carl1961/Telsa-Coil-Winder/Documentation/TelsaCoilWinder.docx

## Overview

The Telsa coil winder was inspired by my son building a couple of different Telsa coil projects. For these projects we would wind and unwind after we noticed an overlap in the wire. It took hours to build a coil that was free of overlaps. A few times, we noticed the overlap only after the coil was completed. We took our chances only to discover that the wire would arc on the overlap destroying the coil.

Our initial solution was to build a coil winder that used a 12-volt motor and foot peddle to slowly turn the coil while you used your fingers to place the wire in the coil. This approach was better than the first, but still proved to be troublesome. We could wind the coil faster, but we also discovered overlap much later which required more unwinding to fix the issues.

We started searching the web for any tesla coil winders that someone might have built. I was not able to find exactly what I was looking for, but I was able to find enough information to develop an approach and identify the required components. Most of my inspiration came from the Masculinity and Kaj Luukko. They both use t-slot rails for structural supports. The credit for my structural design goes to the work done by Masculinity. I already had a bunch of 500MM T slot 2020 Aluminum Extrusion, so I patterned my design after his. By the time I found the link to download the sketch and the TFT files they were no longer available for download. It might be just as well considering I did not, nor did I plan on using all same parts used by Masculinity in my build. The links to the coil winders developed by Masculinity and Kaj Luukko are attached below.

Also note that this guide is not intended to teach you everything that you would need to know, but to provide a list of parts and guidance you can use to assemble you own Telsa Coil winder. You can find the source code for both Nextion and the Arduino UNO in my GitHub that is referenced below. Some of the most important guidance is simple provided as weblinks that you can either watch the YouTube video of read on your own.

## Reference Links

These projects provided inspiration for build that is detailed below.

Tesla Coil Winder - Powered with arduino mega & nextion dispay | Arduino Project (youtube.com) (https://www.youtube.com/watch?v=HymLeTU4M8Q)

W-2Magnify12EOS (youtube.com) (https://www.youtube.com/watch?v=qxfDYMZw_xw)

(61) Tesla coil winding machine - powered by Arduino Nano - YouTube (https://www.youtube.com/watch?v=nC-06ZKFTeI)

(67) Tesla Coil Winder - Project Icarus: Coil Winding Time lapse - YouTube (https://www.youtube.com/watch?v=QP9elbYsko0)

## Operations

The coil winder is controlled by a Nextion user interface (UI). The UI controls several functions.

- Home Button: Sends the wire winding carriage to home position. Moves to the left until it hit the limit switch. Once the limit switch is hit the carriage back up to the right until it just off the limit switch. The coil winder must be homed before any other functions can be done.
- Offset -> Button: Used to position the wire at the start location for the first coil. Move to the right away from the limit switch.
- Offest <- Button : Used to position the wire at the start location for the first coil. Move to the left in the direction of the limit switch.
- Step by 25 or 500 Button: When using offset buttons it tells the winding carriage how many steps to move 25 or 500. The button can have 2 different states.
- Varnish Button: Button causes the coil winding motor to turn continuously so that varnish or shellac can be applied to the coil.
- Coil Length +10, -10, +1 and -1 Buttons: Buttons are used to set the length of the coil. +10 adds 10MM, -10 subtracts 10MM, +1 adds 1MM, -1 subtracts 1MM. For example, pressing +10 four times and pressing +1 three times equals 43MM. Coil length is set in MM.
- AWG Wire Guage 26, 28, 30, 32, 34, and 36 Buttons: Selects the wire size being used.
- Next and Back Buttons: Moves the Nextion display to the next page.
- Back Button: Moves the Nextion display to the previous page.
- Pause Button: Stop process until the pause button is pressed again. The button has 2 separate states.
- Start Button: Starts the main process loops that builds the secondary coil.

### Wire Calculations v4 solution

Getting a compactly wound coil proved to be a little more difficult than I expected. I planned to use the wire diameter and coil length to calculate the number of turns. The wire diameter was used to calculate the number of steps the wire carriage would move between each coil. This led to a few problems.

1. The wire carriage would fall behind as the coil got longer. If the coil was long enough the wire would skip backward and overlap. It would create a coil that was compact but not useful.
2. The last problem was that the coil being created was longer than the length entered in the UI. For example, a 100MM coil when completed was 110MM long. This was due to the wire diameter being less than the actual space the wire was consuming.

To fix the problems, Carl1961 (GitHub) noticed that I had not considered the enamel coating on the wire. The enamel takes up a lot more space than you would think, so I increased the wire carriage step length and wire size used to calculate the number of turns. The step length is determined by the lead screw and you motor controller. This corrected the problems but created coils that were not as compact as I wanted.

The solution to the first two problems was to increase the carriage step length and wire size used to calculate the number of turns. The solution to making the coil more compact was to delay the wire carriage starting. Meaning the wire carriage would only start moving after a few coils were added to the coil. This caused the wire carriage to track behind the coils as the coils were being added. This produced a compactly wound coil.

### Alternative Solution

As alternatives to setting the coil length and having the program calculate the number of turns, I created an alternative implementation that allowed the user to either set the length of the coil or set the number of turns the user wanted on the coil. This alternative implementation allows the user to simply input the number of turns. The program estimates the required coil length for the specified turns. The user just needs to validate that the pipe is long enough to account for the turns specified.

### Wire Tension

Wire tension is created using 5 guide wheels that, so far, have provided enough tenson on the wire. In all fairness, the coil winder has only been tested with AWG, 26, 28, 30, 32, 34, and 36 gauge wire. I have not tested any wire that is larger diameter than 26 or thinner than 36 gauge. Also, you should note that changing the wire size will require changing to the Nextion display and changes to Arduino sketch program.

### Guide and Tension Wheels

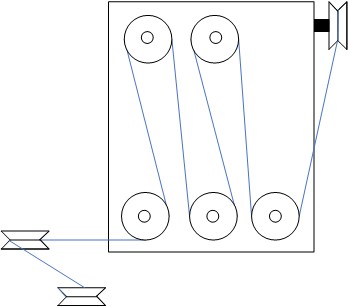
[picture p2: figure]

## Assembly Tools

Tools you will need.

1.5mm Allen Wrench.

2.0mm Allen Wrench.

3.0mm Allen Wrench.

Drill press or handheld drill along with an assortment of Drill bits.

Band saw or hack saw to cut the aluminum rails, supports and stops.

Handheld file to clean up cut aluminum rails and parts.

3D Printer (not required). You can have the parts printed.

## T-Slot cut to the following lengths.

You might be able to buy the length specified directly from Amazon or other sources. The 500MM will limit the size of the coil that can be wound to about 340MM.

(6) = 150mm

(4) = 500mm

(2) = 460mm

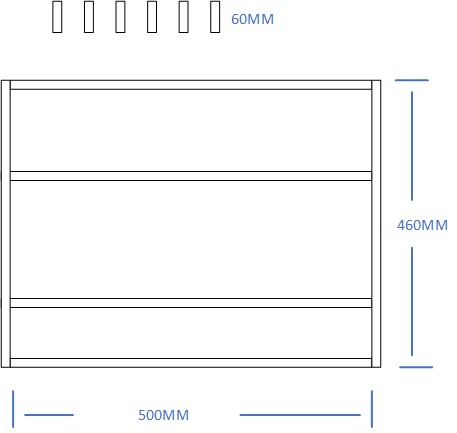
[picture p3: figure]

Note: Carefully consider the length of the largest coil you will be creating. All the parts except for the Liner Actuator and the 2020 T-slot rails can be used with any size coil. These two parts will be the limiting factor as to the coil size. I already had 500MM 2020 T-slot rails, so I ordered a 500MM Liner Actuator which limits me to about a 340MM coil. I could have purchased 1000MM 2020 T-Slot rails and a 1000MM Liner Actuator for a small amount more. Looking back, I should have purchased the 1000MM 2020 T-Slot rails and the 1000MM Liner Actuator. That would have provided roughly an 850MM coil.

## Structural Assembly

The structural assembly is very straight forward. All but a few of the components can be purchased. There are only a few components that need to be constructed from Aluminum angle or 3D printed. I opted to build them from aluminum.

<pictures or Video>

## Stops, spacers and angle brackets.

Using the aluminum flat and angle stock I built the following parts:

(4) .125 x .75 x 1” - Drill a hole in the center to attach the stops to the 2020 T-slot.

(2) .125 x .75 x 2 “ - Drill a hold near the bottom of the plate. It attaches between the 2020 T-slot and the Liner Actuator.

<Picture>

(1) .125 thick x .50 angle x 1.0 angle x ½ long. – used to hold the wire guide wheel.

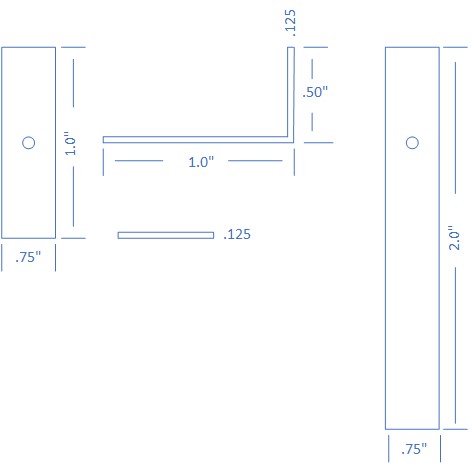
[picture p4: figure]

<See Picture>

## Liner Actuator Bundle kit assembly

My Linear Actuator Bundle came unassembled. Please review the following link to see how to assemble the actuator.

V-Slot® NEMA 17 Linear Actuator Bundle (Lead Screw) (youtube.com) (https://www.youtube.com/watch?v=X0Z_gfl-iGY)

## Electronics assembly

The wiring was for the most part is very straight forward. I used an Arduino Uno to run the controller along with 2 pre-built motor controllers. I used two voltage regulators to decrease the 12 volts coming from the power supply to 5 and 9 volts respectively. You can complete the build without using voltage regulators. I had several extra laying around. The motor controls required a 5-volt supply for the control logic and 12 volts to drive NEMA 17 motors. I used the barrel jack on the Arduino Uno which requires between 7 and 12 volts. I set the voltage in the middle at 9 volts. The Nextion display required 5 volts as well. There are other ways to provide power to the Arduino, Nextion and the motor controllers.

The motor controllers I purchased from Amazon have some limitations that that you need to work around. For example, the motor controllers do not have a sleep pin. As such, there is no easy way to put the motors to sleep. As an alternative, I developed my own PCB that can be used instead. The PCB can be found on GitHub.

You can use easy EDA to modify the design files and recreate your own Gerber files. You can use JLCPCB to have PCB created like I did. There are other options that can be used as well.

If you used the stepper motor controller from Amazon, linked below, the enable pin needs to be set to ground. If not the motors will not turn on.

The wiring is diagrammed below.

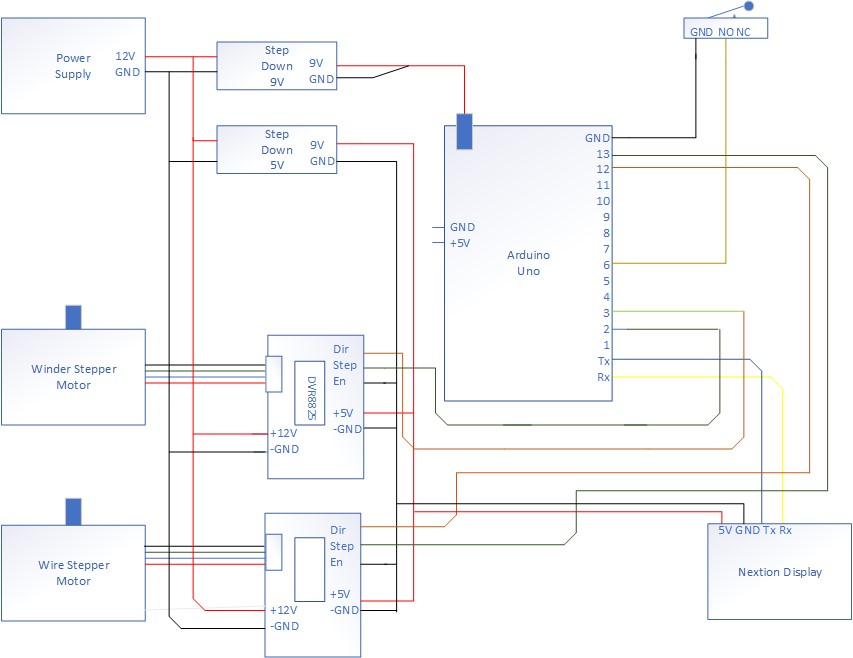
[picture p5: figure]

## Source code and programming:

The source code for this project can be found on GitHub at:

https://github.com/rduart/TelsaCoilWinder.git

Simply clone the repository to your local machine. You will need the contents of the repository to deploy the code to the Nextion display and to the Arduino Uno.

### Nextion Display

You will need to install the Nextion editor if you want to change the UI. As with all UI’s, there are a million ways to change it to make it look and feel the way you want.

Note: you will need a 30gb microSDSHC card to install the CoilWinderV4.tft file on the display. There is a fat32 restriction that requires the 30gb card to be used.

Nextion download link:

DOWNLOAD - Nextion (https://nextion.tech/nextion-editor/)

Nextion Instruction Set - ITEAD Wiki (iteadstudio.com) (https://wiki.iteadstudio.com/Nextion_Instruction_Set)

https://www.arduinolibraries.info/libraries/nextion

If you simply want to deploy our User interface from Github you will need to copy the CoilWinderV4.tft on to the MicroSD card, and follow the instructions in the link below, or find a YouTube video that works for you.

Using the Nextion microSD (upload) - Nextion (https://nextion.tech/faq-items/using-nextion-microsd/)

### Arduino IDE:

To update and deploy the Arduino stretch file you will need to install and configure the Arduino IDE. There are many YouTube videos that can guide you through how to install the IDE.

Please use the following link to set up the Arduino Uno. The IDE assumes you will be using an Arduino mega.

Nextion Display with Arduino - Getting Started | Random Nerd Tutorials (https://randomnerdtutorials.com/nextion-display-with-arduino-getting-started/)

Arduino download link:

Software | Arduino (https://www.arduino.cc/en/software)

#### Libraries:

The following libraries will need to be installed in the Arduino IDE.

AccelStepper.h

AccelStepper - Arduino Reference (https://www.arduino.cc/reference/en/libraries/accelstepper/)

Nextion.h

Nextion - Arduino Libraries (https://www.arduinolibraries.info/libraries/nextion)

Note: The Nextion library proved to problematic. The library did not always work as expected when trying to get variable values from the UI, or when trying to set variable values on the UI. I discovered after much testing that I needed to set or get the variable multiple times. You can see it in the code at various places. It’s a problem that others that have found when using the nextion.h library.

Additional, Nextion links:

Nextion Instruction Set - ITEAD Wiki (iteadstudio.com) (https://wiki.iteadstudio.com/Nextion_Instruction_Set)

Please follow the following link to install the libraries in the Arduino IDE.

Installing Libraries | Arduino Documentation (https://docs.arduino.cc/software/ide-v1/tutorials/installing-libraries/)

## DRV8825 stepper motor controllers.

Before you begin you will need to set the current limit on the DRV8825 motor controller. Please see the following link on how you would set the current limit on the DRV8825 controllers. I ended up upsetting the current limit to .55V. Anything above .55V was causing one of my stepper motors to scatter while stepping. .55V appears to work perfectly for both of my motors.

Stepper Motor with DRV8825 and Arduino Tutorial (4 Examples) (makerguides.com) (https://www.makerguides.com/drv8825-stepper-motor-driver-arduino-tutorial/)

## 3D printed parts

There are a few parts I created using one of my 3D printers. The printed parts were mainly used to support the PVC or acrylic pipe while making the Telsa coil. The stl and gcode files can be found on github.

These printer files support the following sizes:

- 2 ID x 2.5 OD – Acrylic Pipe
- 1.5 ID x 2 OD – PVC Pipe
- 1.75 ID x 2 OD – Acrylic Pipe
- 3 ID x 3.5 OD – PVC Pipe
- 2.75 ID x 3.0 OD – Acrylic Pipe

## Supplies/parts

For this build, you will need the following parts (all available from Amazon.com, Blukman.com, or Openbuilds.com, or similar websites):

Most of the products can be purchased directly from Amazon, Bulkman or Openbuilds. The parts are a little less expensive from Bulkman, but the cost of shipping will offset the lower cost if your shipping destination is in the USA. You will need to run some calculations to determine the cheapest or best place for you to buy. I included links for each of the parts.

500mm T slot 2020 Aluminum Extrusion – Rails structure

SeekLiny 10PCS T Slot 2020 Aluminum Extrusion European Standard 500mm(19.6’’) Length Anodized Extruded Aluminum for CNC DIY 3D Printer and Industrial Bracket Making: Amazon.com: Industrial & Scientific (https://www.amazon.com/SeekLiny-Aluminum-Extrusion-European-Industrial/dp/B0CN6NPBD2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)

Anti-Vibration Rubber Landing Mat Feet -- Rubber feet for the rail structure

Amazon.com: MakerHawk 20 Sets Anti-Vibration Rubber Landing Mat Feet, T Sliding Nut Block Square Nuts, M3 Screws with 1pc Wrench 3D Printer Accessories for 2020 Aluminum Extrusion Profile : Industrial & Scientific (https://www.amazon.com/dp/B07JKDZWKR?tag=jprytikov-20&geniuslink=true)

Nextion Display 4.3 - UI display to control the winder

Amazon.com: NEXTION Display 4.3 NX4827T043 Touchscreen : Electronics (https://www.amazon.com/dp/B07B9XTSWH?tag=jprytikov-20&geniuslink=true)

Rigid Flange Coupling Motor Guide Shaft Coupler - Used to connect the 3D printer parts to the winder rod.

Amazon.com: uxcell 10mm Inner Dia H13*D16 Rigid Flange Coupling Motor Guide Shaft Coupler Motor Connector Silver Tone 2 PCS for DIY Parts : Industrial & Scientific (https://www.amazon.com/dp/B07PLBRMDQ?tag=jprytikov-20&geniuslink=true)

Power Supply 5V 12V 24V Output -- Power for all components

Amazon.com: Arcity 5V 12V 24V Output Switching Power Supply Unit Adjustable for Video Multi Games Machine Console Cocktail CCTV Computer DIY New : Electronics (https://www.amazon.com/dp/B07RT54H9V?tag=jprytikov-20&geniuslink=true)

Bergen Industries Inc PS613163 3-Wire Appliance and Power Tool Cord, 6 ft -- Cord to connect the poser supply to the electrical power.

Bergen Industries Inc PS613163 3-Wire Appliance and Power Tool Cord, 6 ft, 16 AWG, 13A/125V AC, 1625w,Black - Amazon.com (https://www.amazon.com/Bergen-Industries-Inc-PS613163-Appliance/dp/B07C9D6CXY?s=industrial)

90 Degree Angle Brackets Interior Joint Corner Bracket - Structural parts for assembly.

Amazon.com: KOOTANS 20-Pack 90 Degree Angle Brackets Interior Joint Corner Bracket for European Standard 2020 Series T Slot 6mm Aluminum Extrusion Profile, with Screws and Wrench : Industrial & Scientific (https://www.amazon.com/dp/B07PJ8H5ZQ?tag=jprytikov-20&geniuslink=true&th=1)

GT2 Synchronous Wheel 20&60 Teeth 8mm Bore – Used to connect the winder motor the winder rod.

Zeelo 2PCS Set GT2 Synchronous Wheel 20&60 Teeth 8mm Bore Aluminum Timing Pulley with 2PCS Length 200mm Width 6mm Belt (20-60T-8B-6): Amazon.com: Industrial & Scientific (https://www.amazon.com/Zeelo-Synchronous-Aluminum-Timing-20-60T-8B-6/dp/B0BYVFNYWM?s=industrial)

Jumper Wires – Used to connect the electrical components.

Amazon.com: EDGELEC 120pcs Breadboard Jumper Wires 10cm 15cm 20cm 30cm 40cm 50 cm 100cm Wire Length Optional Dupont Cable Assorted Kit Male to Female Male to Male Female to Female Multicolored Ribbon Cables : Electronics (https://www.amazon.com/dp/B07GD2BWPY?tag=jprytikov-20&geniuslink=true&th=1)

8mm Inner Bore Ball Mounted Pillow Block Flange - Used to connect the winder rod and wire rod to the structure.

8mm Inner Bore Ball Mounted Pillow Block Flange Micro Vertical Bearing, Pack of 4: Amazon.com: Industrial & Scientific (https://www.amazon.com/UNIMORE-Mounted-Pillow-Vertical-Bearing/dp/B0B2JQRM23?s=industrial)

Aluminum Profile Connector 90 Degree Corner - Structural parts for assembly.

Amazon.com: Artilife 20 Sets Aluminum Profile Connector Set Including 20pcs 90 Degree Corner Brackets, 40pcs M5 T Nuts and M5 Hex Screw Bolt for Slot 6mm 20S Aluminum Rail Accessories (Black) : Industrial & Scientific (https://www.amazon.com/dp/B08PCTFNWD?tag=jprytikov-20&geniuslink=true&th=1)

GT2 Pulley 20 Teeth 5mm Bore -- Winder stepper motor pulley

TMYPN 5PCS GT2 Pulley 20 Teeth 5mm Bore for Ender 3 V2 Pro 3s CR10 CR-10S CR6 SE 3D Printer Parts 6mm Width 20T Timing Belt, Aluminum 3D Printer Timing Belt Pulley Wheel with Allen Wrench: Amazon.com: Industrial & Scientific (https://www.amazon.com/TMYPN-Pulley-CR-10S-Printer-Aluminum/dp/B0CPYN865G?sp_csd=d2lkZ2V0TmFtZT1zcF9hdGY)

Arduino Uno REV3 - Controller

Amazon.com: Arduino Uno REV3 [A000066] : Electronics (https://www.amazon.com/gp/aw/d/B008GRTSV6/?aaxitk=3501c7a23c342f753fd19465a2e9adf6&hsa_cr_id=5130128880501)

DRV8825 Stepper Motor Driver Module – Needed if using custom PCB

Amazon.com: Teyleten Robot 3D Printer Parts DRV8825 Stepper Motor Driver Module with Heat Sink for Ramps 1.4 StepStick A4988 (5pcs) : Industrial & Scientific (https://www.amazon.com/Teyleten-Robot-Printer-DRV8825-StepStick/dp/B0CP92T4QR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)

Type-30 Miter Track Stop, Aluminum Alloy T Slot Stop - wire guide

Type-30 Miter Track Stop, Aluminum Alloy T Slot Stop Fence Chute Limiter Woodworking DIY for 30MM T-Slot T-Tracks Woodworking Guide Rail - Amazon.com (https://www.amazon.com/Miter-T-Slot-T-Tracks-Woodworking-Locator/dp/B09PYFWYM3)

DC to DC Voltage Regulator 4-40V - used to reduce volage to 9 or 5 volts.

Amazon.com: Valefod 3 Pack LM2596 DC to DC Voltage Regulator 4-40V to 1.5-35V Buck Converter with LED Display : Electronics (https://www.amazon.com/Valefod-Voltage-Regulator-1-5-35V-Converter/dp/B07WQJ2GD6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)

STEPPERONLINE NEMA 17 Stepper Motor mounting -- Motor mounting plate

STEPPERONLINE NEMA 17 Stepper Motor (Economy Geared Stepper Motor) Alloy Steel Mounting Bracket ST-M1 - Amazon.com (https://www.amazon.com/dp/B00Q6F51C0?tag=jprytikov-20&geniuslink=true)

Nema 17 Stepper Motor

STEPPERONLINE Nema 17 Stepper Motor Bipolar 2A 59Ncm(84oz.in) 48mm Body 4-Lead W/ 1m Cable and Connector Compatible with 3D Printer/CNC - Amazon.com (https://www.amazon.com/dp/B00PNEQKC0?tag=jprytikov-20&geniuslink=true)

V-Slot NEMA 17 Linear Actuator Kit 500mm --

V-Slot NEMA 17 Linear Actuator Kit (bulkman3d.com) (https://bulkman3d.com/product/v-slot-nema-17-linear-actuator-kit/)

Or

V-Slot® NEMA 17 Linear Actuator Bundle (Lead Screw) - OpenBuilds Part Store (https://openbuildspartstore.com/v-slot-nema-17-linear-actuator-bundle-lead-screw/)

Metal Dual V Wheel -- used as wire guides and tension

Metal Dual V Wheel Kit Unassembled (bulkman3d.com) (https://bulkman3d.com/product/vk0008/)

Or

Dual V Wheel Kit - Metal - Maker Store USA (https://makerstore.cc/product/dual-v-wheel-kit-metal/)

10 V-156-1C25 Micro Limit Switch -- Limit switch

BlueStars Pack of 10 V-156-1C25 Micro Limit Switch Blade Momentary 250VAC/125VDC 15A Perfect for Arduino, Appliance and General Electrical Equipment Supplies: Amazon.com: Industrial & Scientific (https://www.amazon.com/BlueStars-V-156-1C25-Momentary-Appliance-Electrical/dp/B0CR1JJMJ7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)

DC Power Cable 5A 12v DC Power Plug Cord Male -- Connects Arduino to 9 volts.

Amazon.com: CENTROPOWER 20 Pcs DC Power Cable 5A 12v DC Power Plug Cord Male Connectors 2.1mm x 5.5mm, DC Pigtail Adapter Plug Socket Wire?for CCTV Security Camer : Electronics (https://www.amazon.com/CENTROPOWER-Connectors-Pigtail-Adapter-Security/dp/B0BTHSDF4S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)

DRV8825/A4988 Stable 42 Stepper Motor Driver Expansion Board 3D Printer Control Shield Module for 3D Printer -- Not needed if using the custom PCB.

Amazon.com: DRV8825/A4988 Stable 42 Stepper Motor Driver Expansion Board 3D Printer Control Shield Module for 3D Printer (1) : Industrial & Scientific (https://www.amazon.com/DRV8825-Stepper-Expansion-Printer-Control/dp/B08RP2SCJ7)

Motor Couplers to connect 3D printed tube ends to winding motor

Amazon.com: uxcell 8mm Inner Dia H13*D16 Rigid Flange Coupling Motor Guide Shaft Coupler Motor Connector Silver Tone for DIY Parts : Industrial & Scientific (https://www.amazon.com/uxcell-H13D16-Coupling-Coupler-Connector/dp/B07PFWT47Q)

Aluminum stock to build stops and spacers, or big box store.

Amazon.com: 10 Pieces 1/8"x 3/4" ALUMINUM 6061 FLAT BAR 12" Long +.07"/-0 Solid T6511 New Extruded Bar Stock : Industrial & Scientific (https://www.amazon.com/Pieces-ALUMINUM-Solid-T6511-Extruded/dp/B01F80W26Q?s=industrial)

Aluminum stock to build wire guide wheel support.

Amazon.com: Orange Aluminum Industrial 90-Degree Angled Extrusion - Aluminum Channel, Used for Home Improvement, T5-Temper, USA-Made, ASTM B221-14 Compliant, Lightweight for DIY and Construction : Industrial & Scientific (https://www.amazon.com/Orange-Aluminum-Extrusion-Extruded-Bracket/dp/B07RB7HHC8?s=industrial)
