carl1961/Telsa-Coil-Winder/EasyEDA/Schematic_DVR8825V5_2024-05-20.png

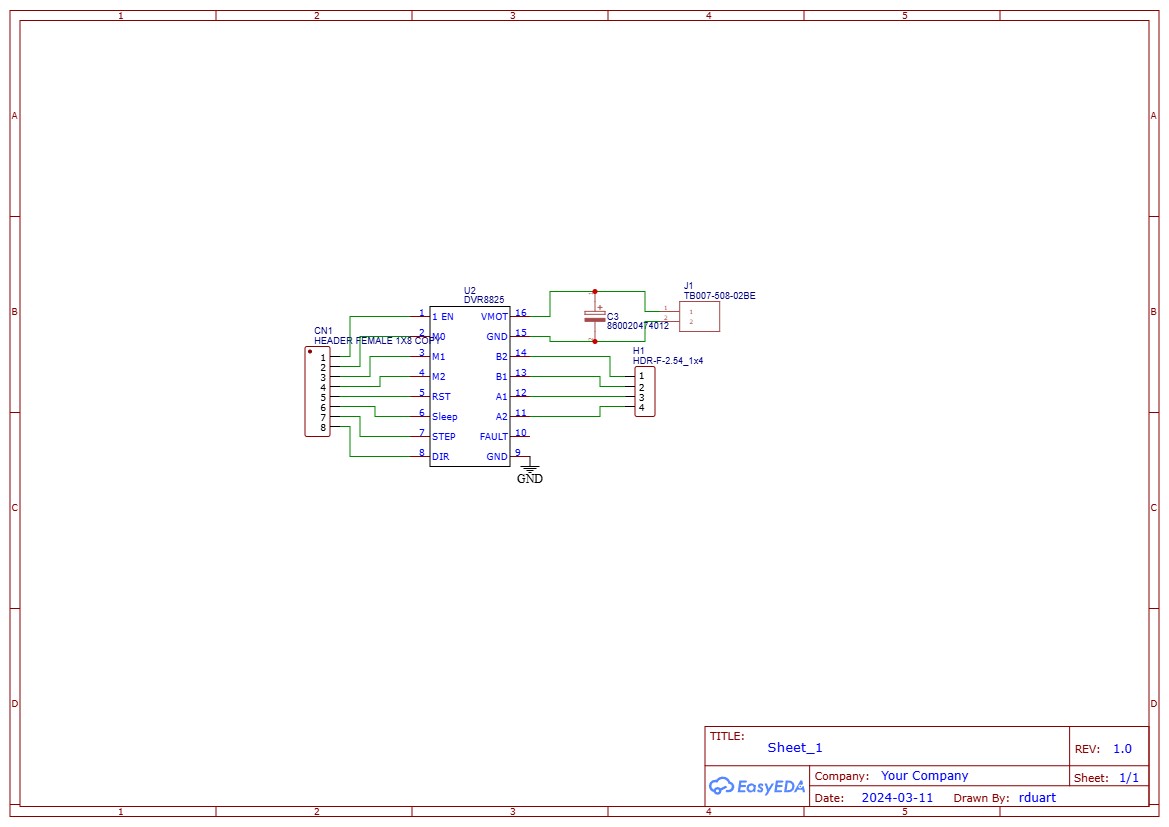
EasyEDA/Schematic_DVR8825V5_2024-05-20.png
