carl1961/Telsa-Coil-Winder/Images/20240512_073756.jpg

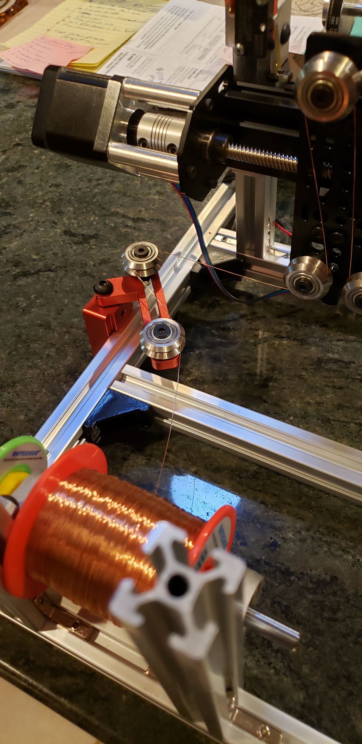
Images/20240512_073756.jpg
