carl1961/Telsa-Coil-Winder/Images/20240512_073829.jpg

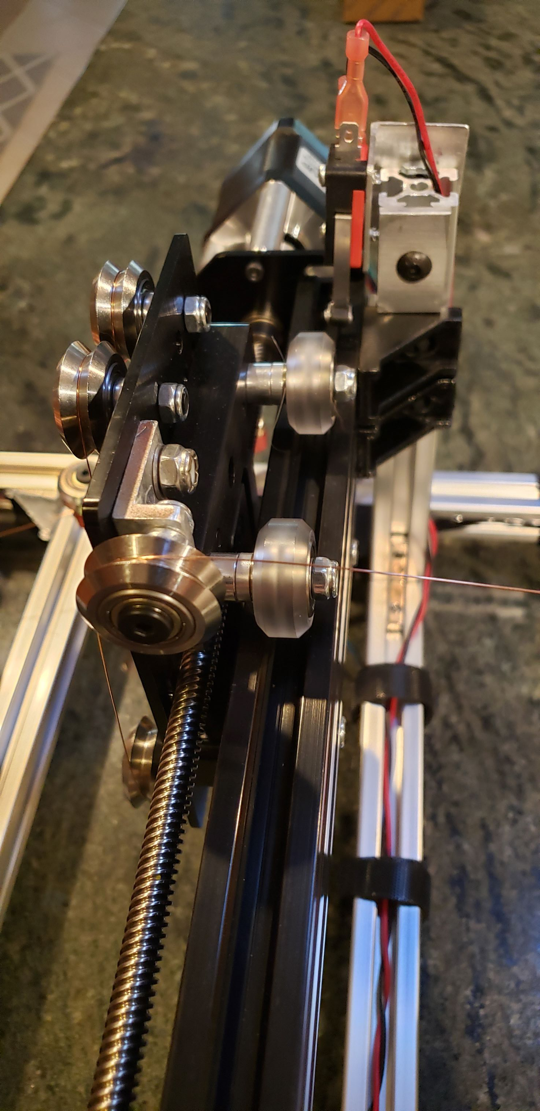
Images/20240512_073829.jpg
