carl1961/Telsa-Coil-Winder/Images/20240512_082015.jpg

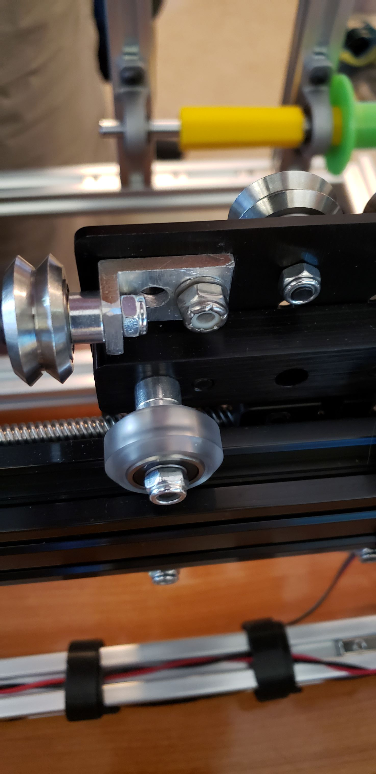
Images/20240512_082015.jpg
