carl1961/Telsa-Coil-Winder/Images/20240512_082049.jpg

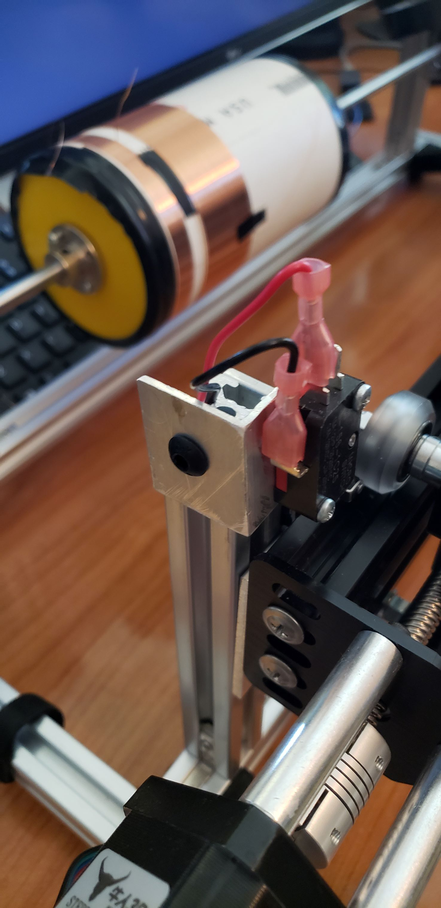
Images/20240512_082049.jpg
