carl1961/Telsa-Coil-Winder/Images/Awg26Wire.jpg

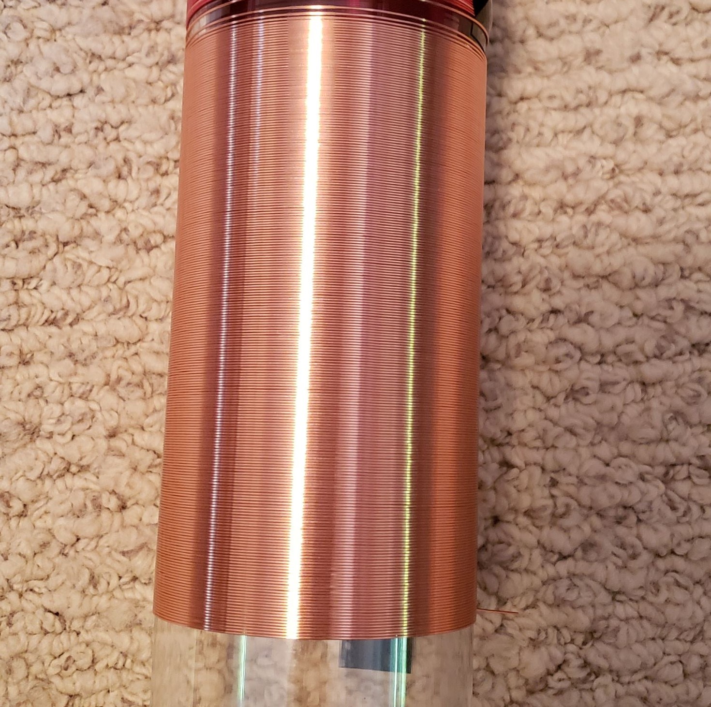
Images/Awg26Wire.jpg
