carl1961/Telsa-Coil-Winder/Images/Awg28Wire.jpg

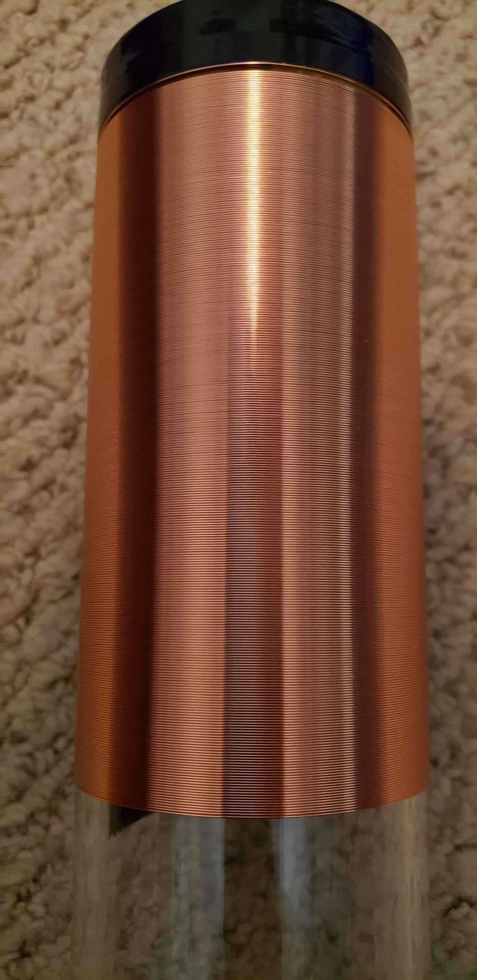
Images/Awg28Wire.jpg
