carl1961/Telsa-Coil-Winder/Images/Awg32Wire.jpg

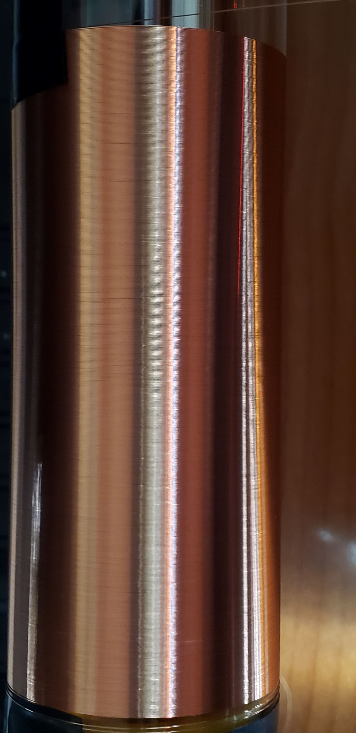
Images/Awg32Wire.jpg
