carl1961/Telsa-Coil-Winder/Images/Awg36Wire.jpg

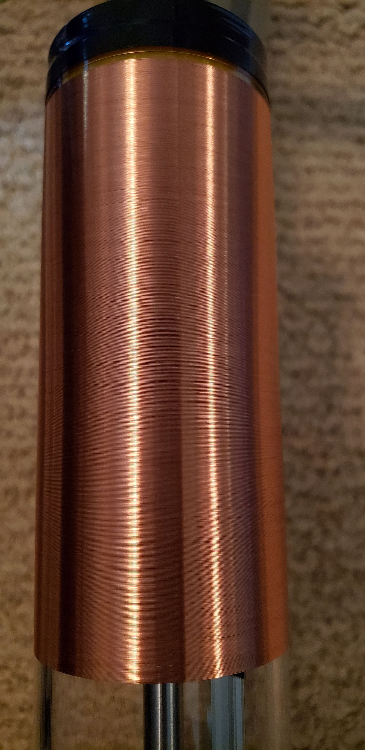
Images/Awg36Wire.jpg
