carl1961/Telsa-Coil-Winder/Images/Coil1.jpg

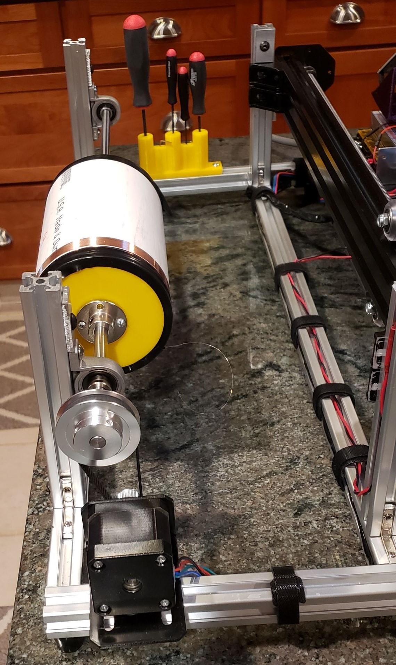
Images/Coil1.jpg
