carl1961/Telsa-Coil-Winder/Images/Coil2.jpg

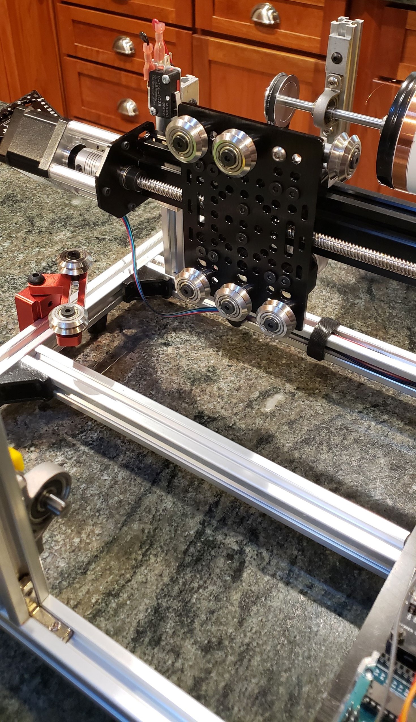
Images/Coil2.jpg
