carl1961/Telsa-Coil-Winder/Images/Coil3.jpg

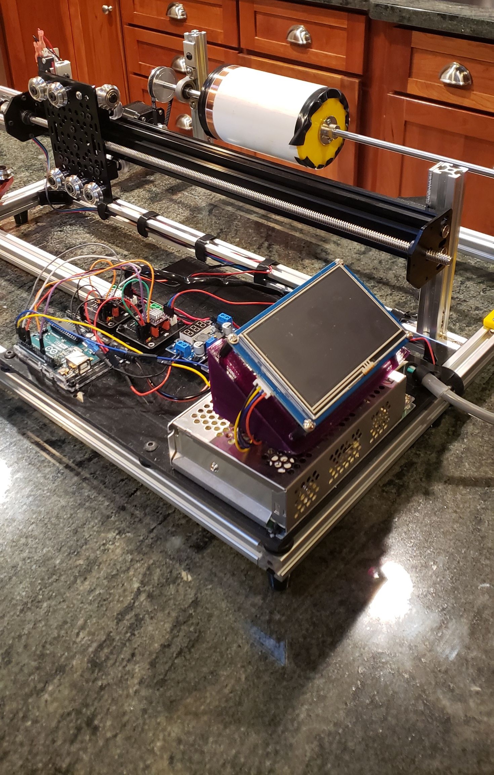
Images/Coil3.jpg
