carl1961/Telsa-Coil-Winder/Images/Electronics.jpg

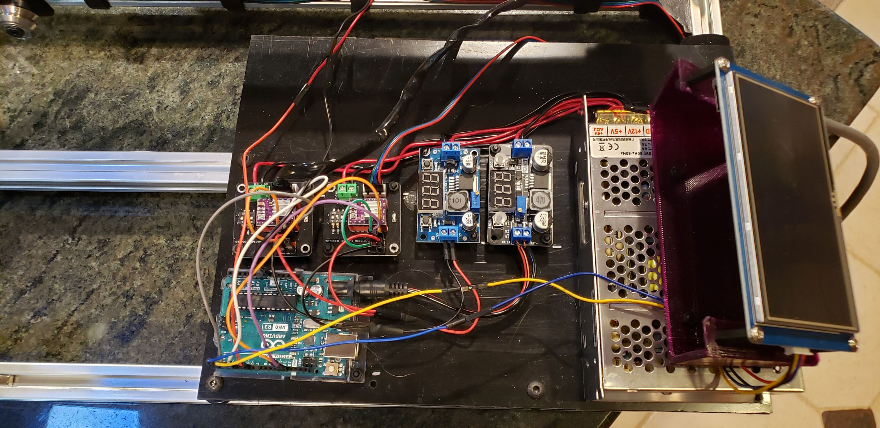
Images/Electronics.jpg
