carl1961/Telsa-Coil-Winder/Images/page0.jpg

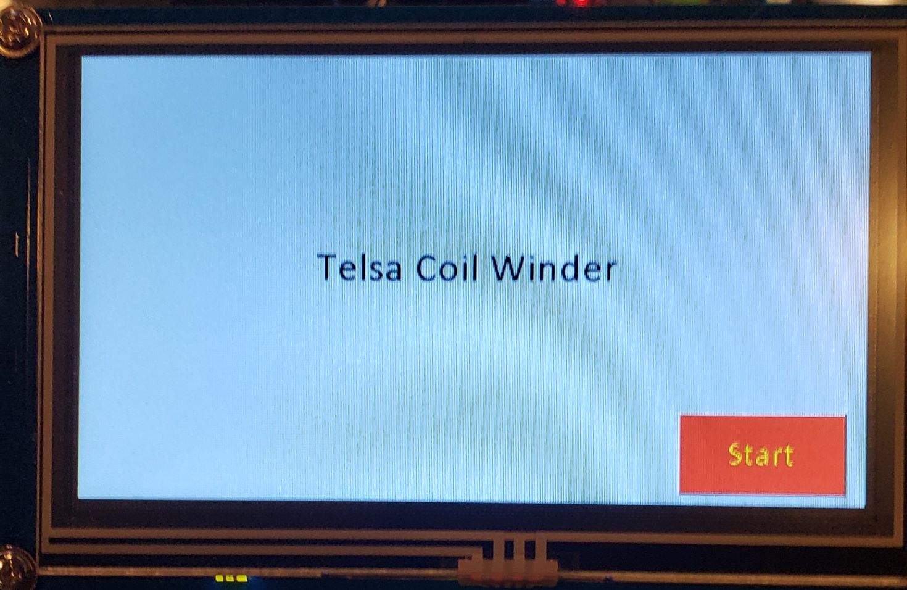
Images/page0.jpg
