carl1961/Telsa-Coil-Winder/Images/page1.jpg

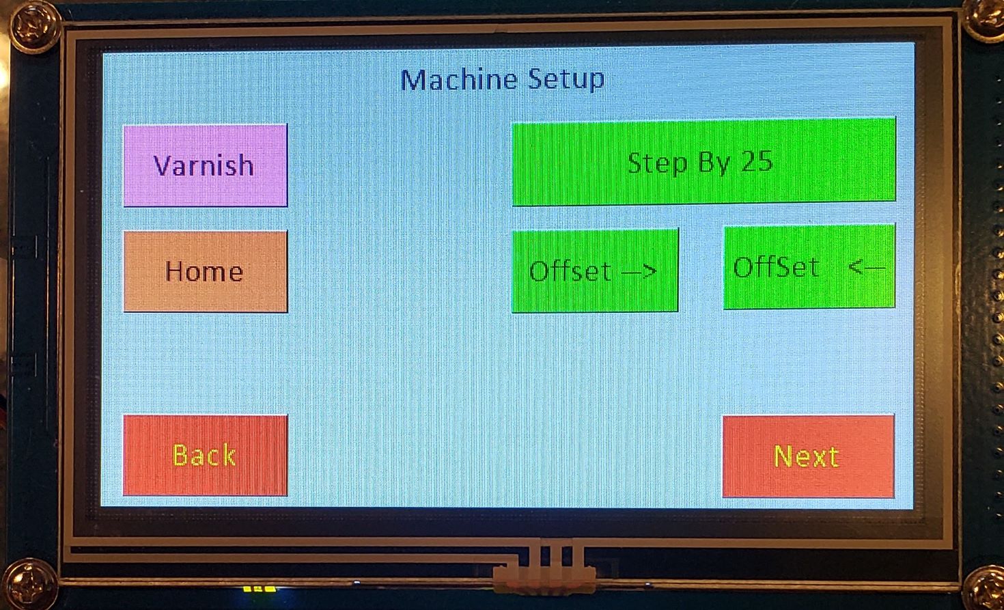
Images/page1.jpg
