carl1961/Telsa-Coil-Winder/Images/page2.jpg

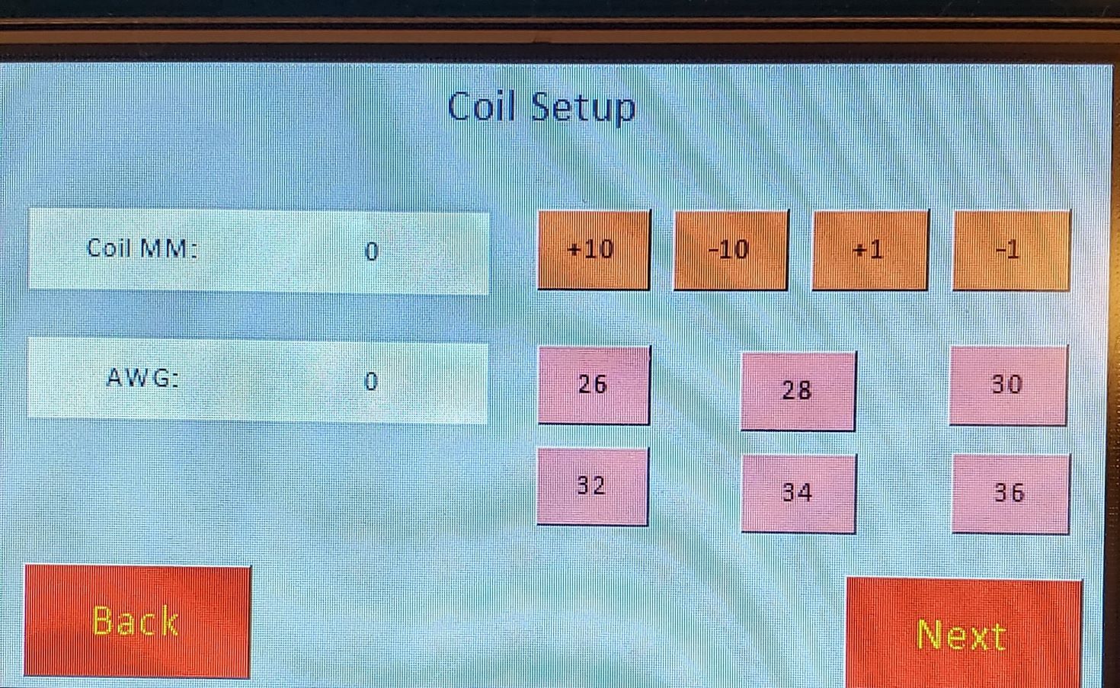
Images/page2.jpg
