carl1961/Telsa-Coil-Winder/Images/page3.jpg

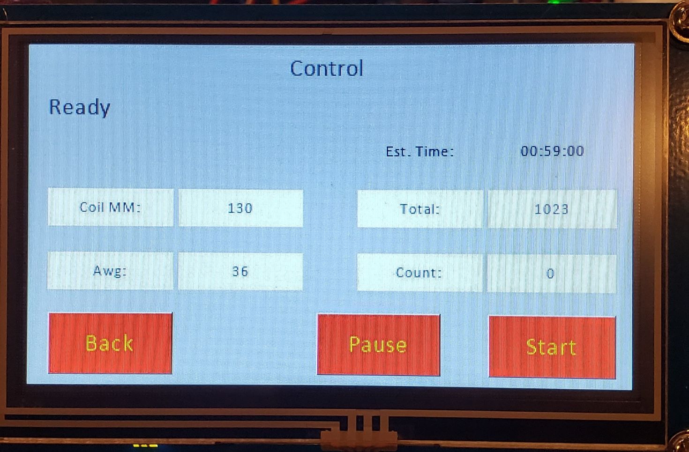
Images/page3.jpg
