carl1961/Telsa-Coil-Winder/Images/Tension.jpg

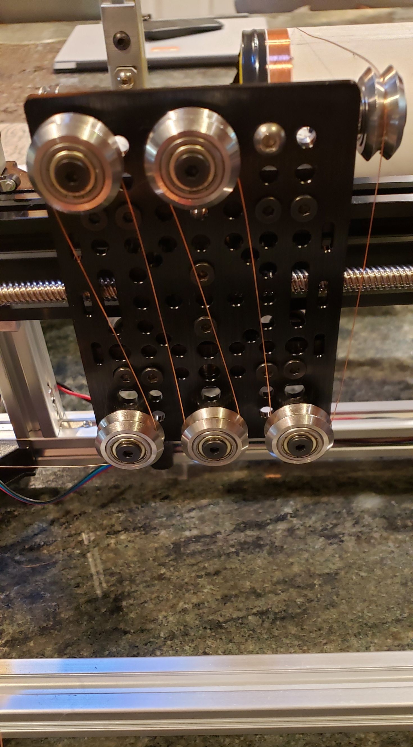
Images/Tension.jpg
