carl1961/Telsa-Coil-Winder/Images/WindingAwg26.jpg

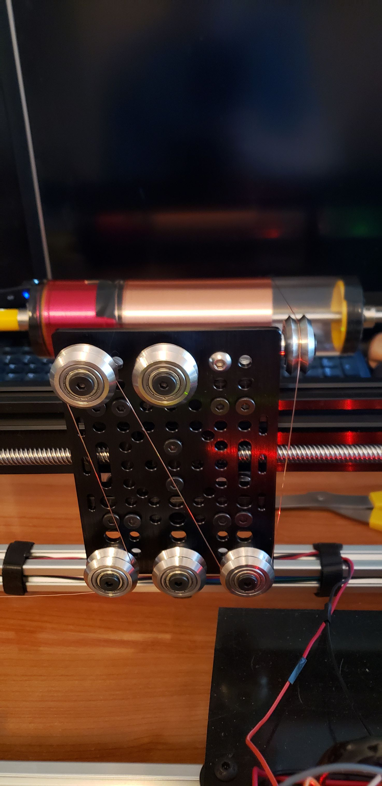
Images/WindingAwg26.jpg
