carl1961/Telsa-Coil-Winder/My files/Control.png

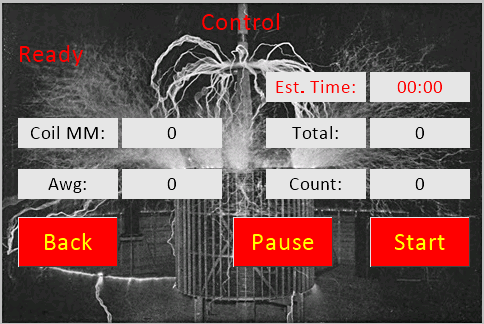
My files/Control.png
