carl1961/Telsa-Coil-Winder/My files/nikola-tesla2.jpg

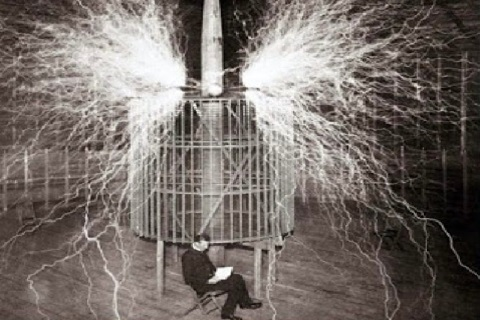
My files/nikola-tesla2.jpg
