carl1961/Telsa-Coil-Winder/My files/Nikola-Tesla3.jpg

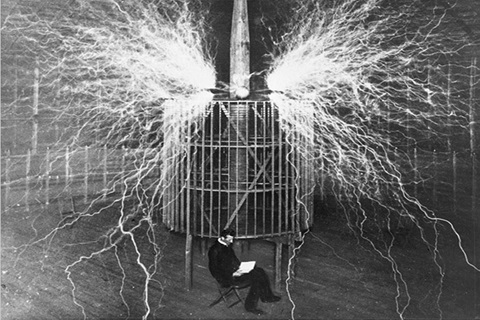
My files/Nikola-Tesla3.jpg
