carl1961/Telsa-Coil-Winder/My files/nikola-tesla.jpg

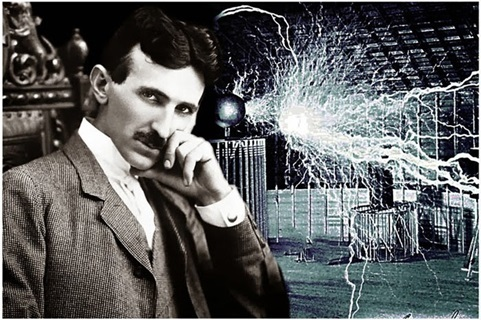
My files/nikola-tesla.jpg
