carl1961/Telsa-Coil-Winder/My files/Nikola_Tesla_with_his_equipment.png

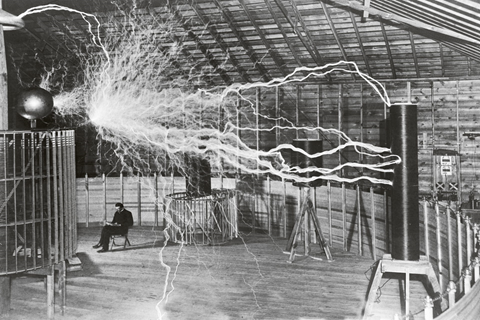
My files/Nikola_Tesla_with_his_equipment.png
