carl1961/Telsa-Coil-Winder/My files/Start.png

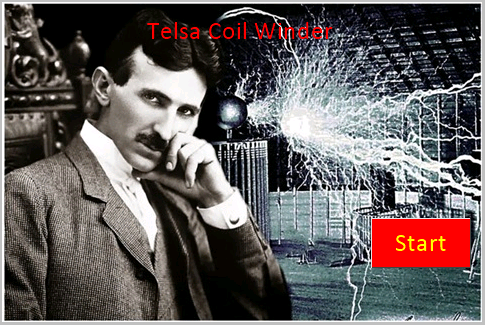
My files/Start.png
