carl1961/Telsa-Coil-Winder/My files/tesla-coil.jpg

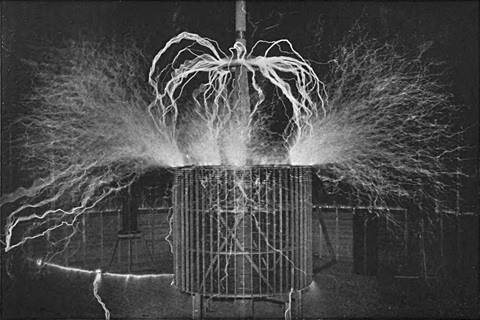
My files/tesla-coil.jpg
