carl1961/Telsa-Coil-Winder/My files/Coil Setup.png

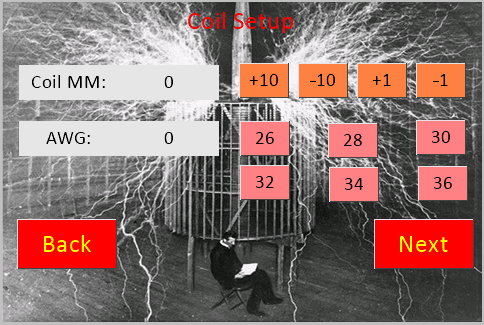
My files/Coil Setup.png
