carl1961/Telsa-Coil-Winder/My files/Machine Setup.png

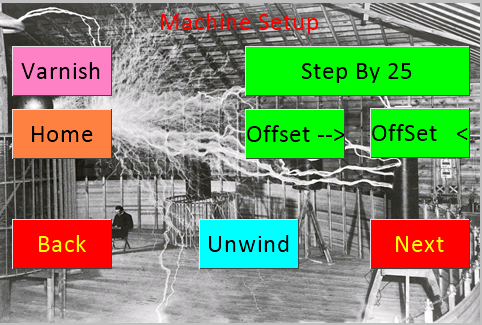
My files/Machine Setup.png
